mtech-ee/HighAltitudeSoilSensing/Pictures/Batteries.jpg

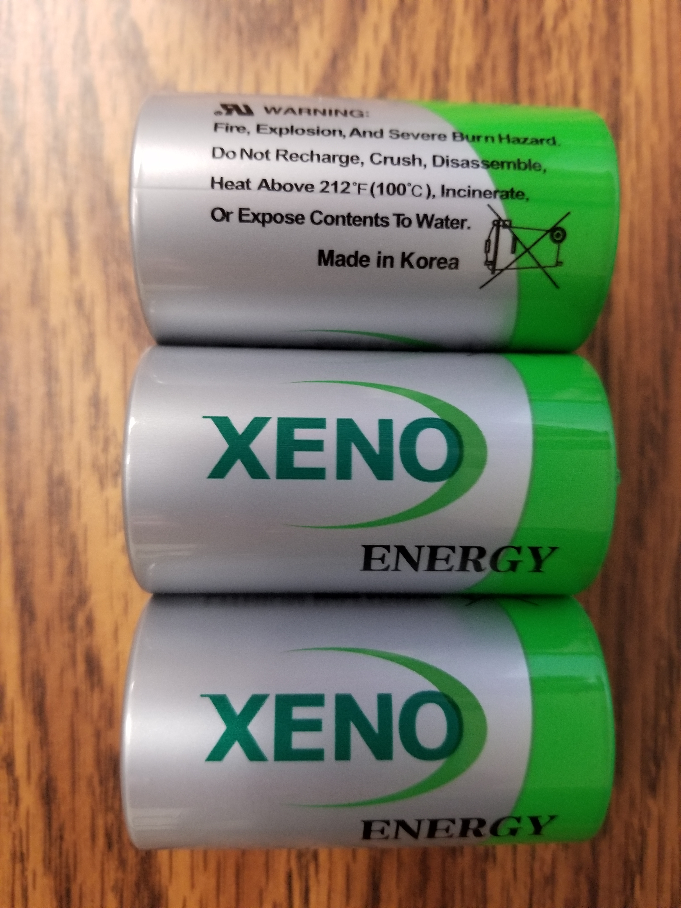
Pictures/Batteries.jpg
