mtech-ee/HighAltitudeSoilSensing/Pictures/prototype.jpg

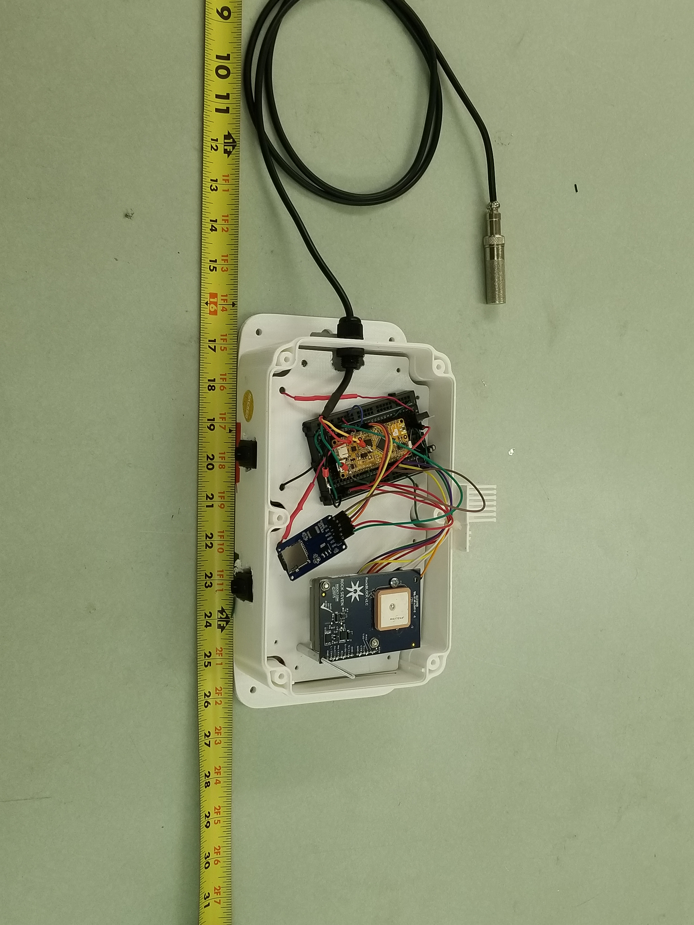
Pictures/prototype.jpg
