mtech-ee/HighAltitudeSoilSensing/README.md

# HighAltitudeSoilSensing
Reading soil temperature and moisture remotely using a RocketScream microcontroller and custom PCB
