mtech-ee/HighAltitudeSoilSensing/Documents/Senior Design/Documentation/Calculations.docx

RockBLOCK:(((2.8+4)As)/(7 days)+(8.537As)/(day))*(365 days)/(1 year)* (1 Ah)/(3600 As)=(0.9727 Ah)/(year)

Arduino:50 mA*(1 A)/(1000 mA)*(5 min)/(1 day)* (1 hour)/(60 min)* (365 days)/(1 year)=(1.521 Ah)/(year)

RocketScream:(20 mA*(1 A)/(1000 mA)*(5 min)/(1 day)* (1 hour)/(60 min)* (365 days)/(1 year))+

20 µA*(1 A)/(1*10^6 µA)*(23.917 hours)/(1 day)* (365 days)/(1 year)=(0.783 Ah)/(year)

Total:(0.9727 Ah)/(year)+(1.521 Ah)/(year)+(0.783 Ah)/(year) =(3.2767 Ah)/(year)

⁶
