mtech-ee/HighAltitudeSoilSensing/Documents/Senior Design/Documentation/Gantt Chart.xlsx

Project Planner
Select a period to highlight at right. A legend describing the charting follows. |  |  |  |  | Period Highlight: | 1 |  |  | Plan Duration |  |  |  |  |  | Actual Start |  |  |  |  | % Complete |  |  |  |  | Actual (beyond plan) |  |  |  | % Complete (beyond plan)
ACTIVITY | PLAN START | PLAN DURATION | ACTUAL START | ACTUAL DURATION | PERCENT COMPLETE | PERIODS
 |  |  |  |  |  | 1 | 2 | 3 | 4 | 5 | 6 | 7 | 8 | 9 | 10 | 11 | 12 | 13 | 14 | 15 | 16 | 17 | 18 | 19 | 20 | 21 | 22 | 23
Project Setup | 1 | 2 |  |  | 0%
Initial Attempt Work | 3 | 3 |  |  | 0%
Test Initial Prototype | 6 | 2 |  |  | 0%
Rework Initial Design | 8 | 3 |  |  | 0%
Test New Prototype | 11 | 1 |  |  | 0%
Rework Design | 12 | 2 |  |  | 0%
Test New Prototype | 14 | 1 |  |  | 0%
Rework to Final | 15 | 2 |  |  | 0%
Final Prototype | 17 | 1 |  |  | 0%
Testing & Final Tweaks | 18 | 4 |  |  | 0%
TXPO Prep | 21 | 3 |  |  | 0%
