mtech-ee/HighAltitudeSoilSensing/Documents/DataSheets/In System/RockBlock Drawing.png

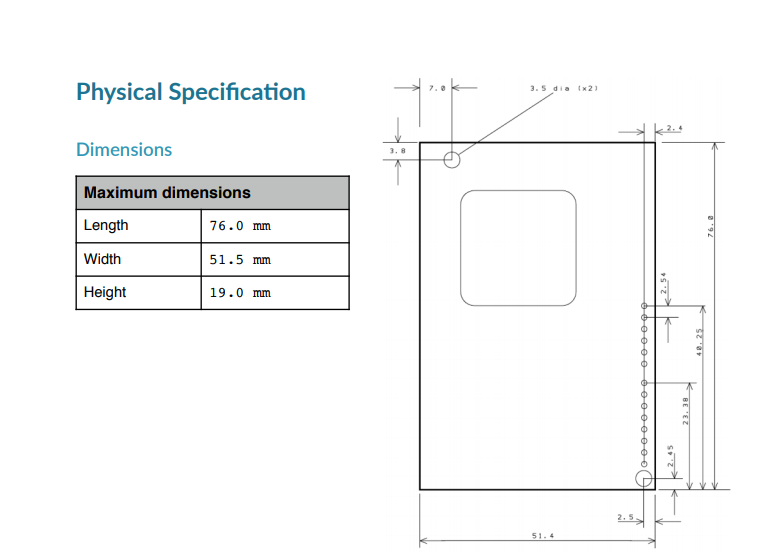
Documents/DataSheets/In System/RockBlock Drawing.png
