mtech-ee/HighAltitudeSoilSensing/Pictures/3.3V LDO.PNG

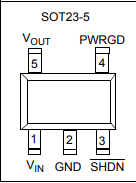
Pictures/3.3V LDO.PNG
