mtech-ee/HighAltitudeSoilSensing/Pictures/Capture.PNG

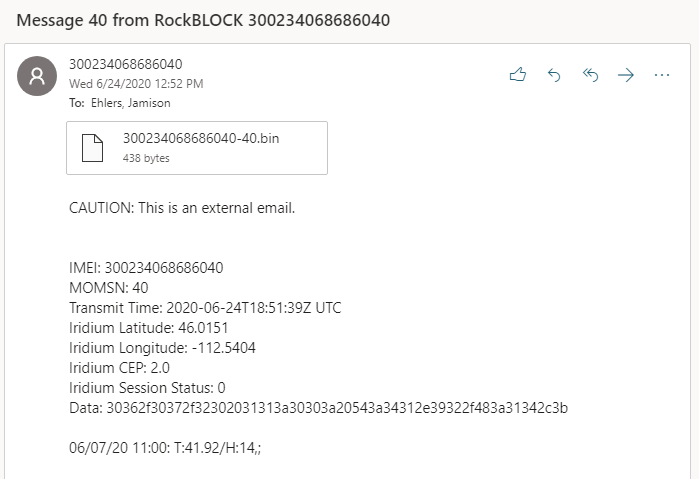
Pictures/Capture.PNG
