mtech-ee/HighAltitudeSoilSensing/Pictures/Figure1.png

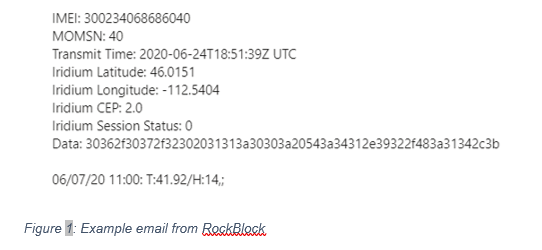
Pictures/Figure1.png
