mtech-ee/HighAltitudeSoilSensing/Pictures/HAST_PCB_v3_schematic.PNG

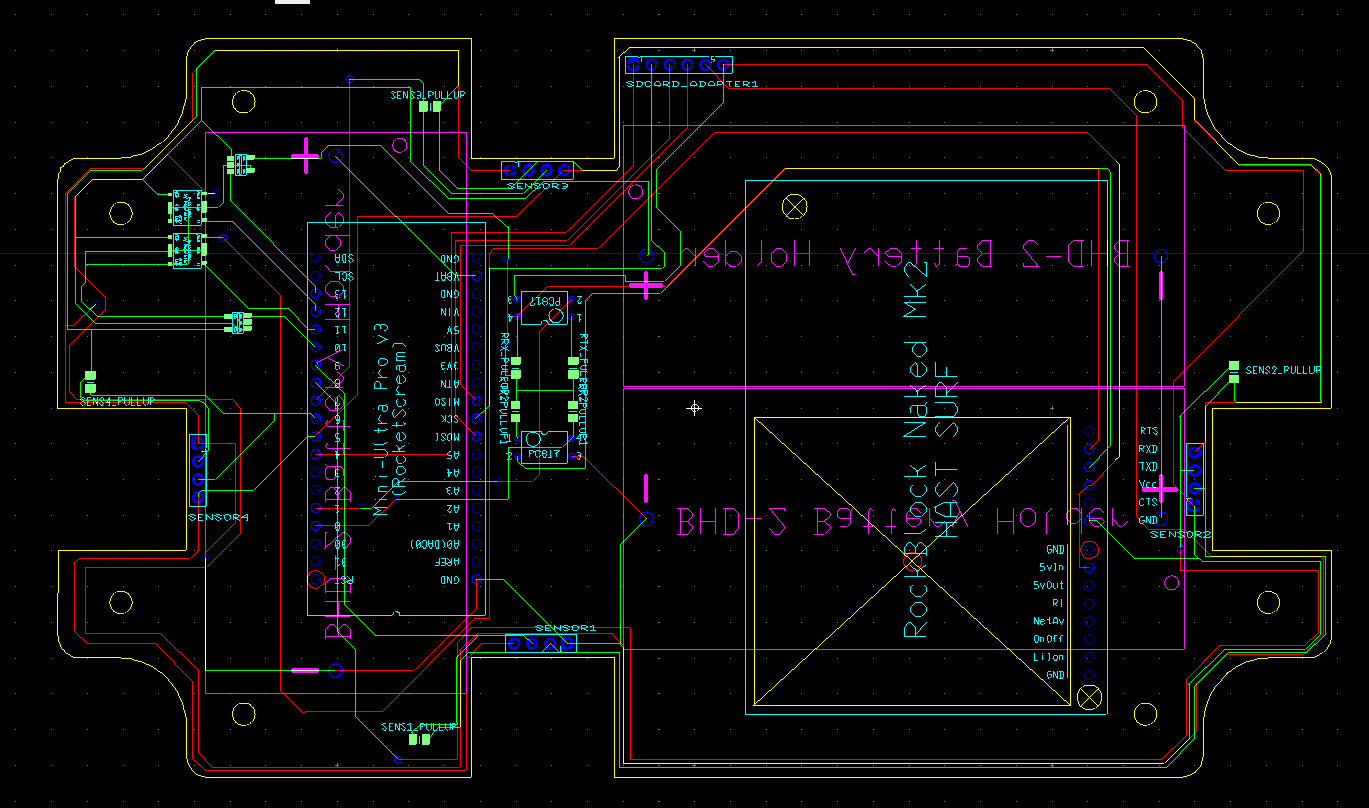
Pictures/HAST_PCB_v3_schematic.PNG
