mtech-ee/HighAltitudeSoilSensing/Pictures/Optocoupler.PNG

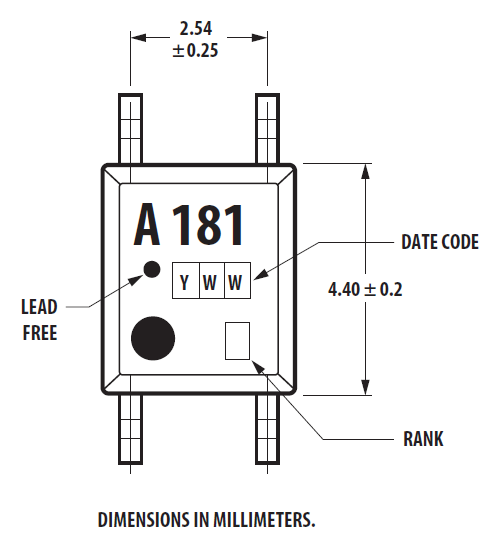
Pictures/Optocoupler.PNG
