mtech-ee/HighAltitudeSoilSensing/Pictures/prototypev2.jpg

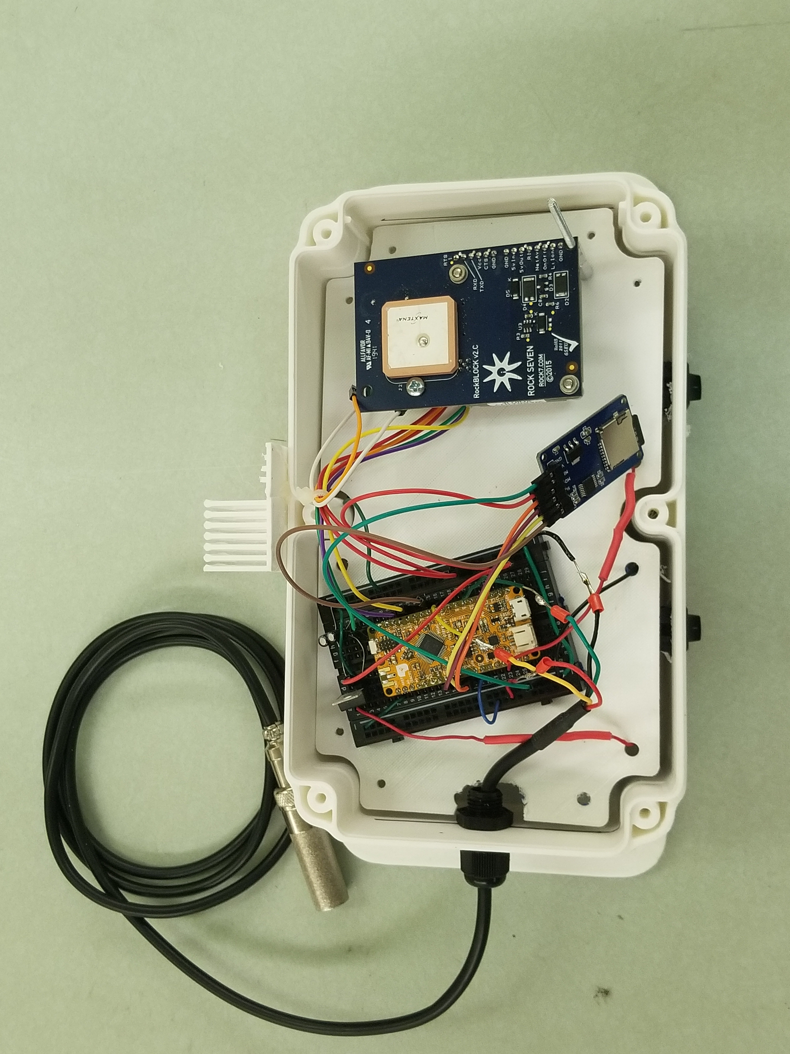
Pictures/prototypev2.jpg
