mtech-ee/HighAltitudeSoilSensing/Pictures/RockBlock.jpg

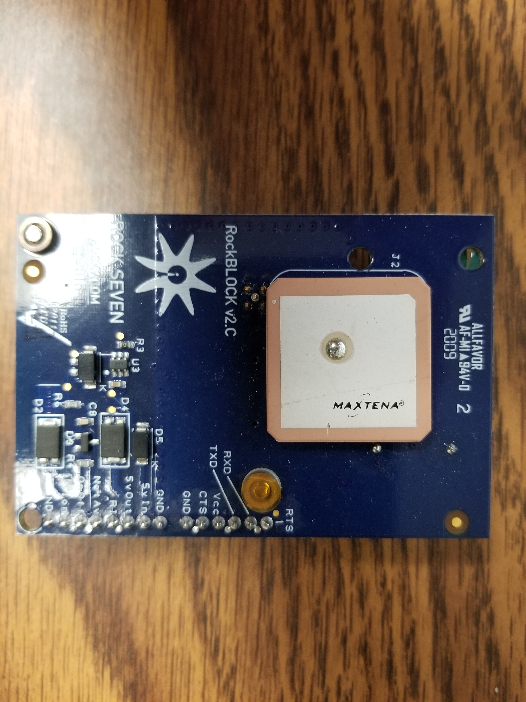
Pictures/RockBlock.jpg
