mtech-ee/HighAltitudeSoilSensing/Pictures/RocketScream.jpg

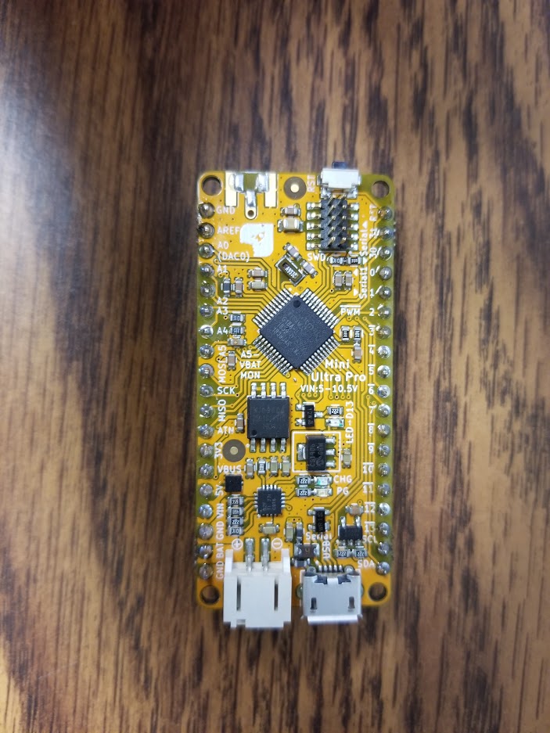
Pictures/RocketScream.jpg
