mtech-ee/HighAltitudeSoilSensing/PowerModel/CSCI477 Term Simulation Model.png

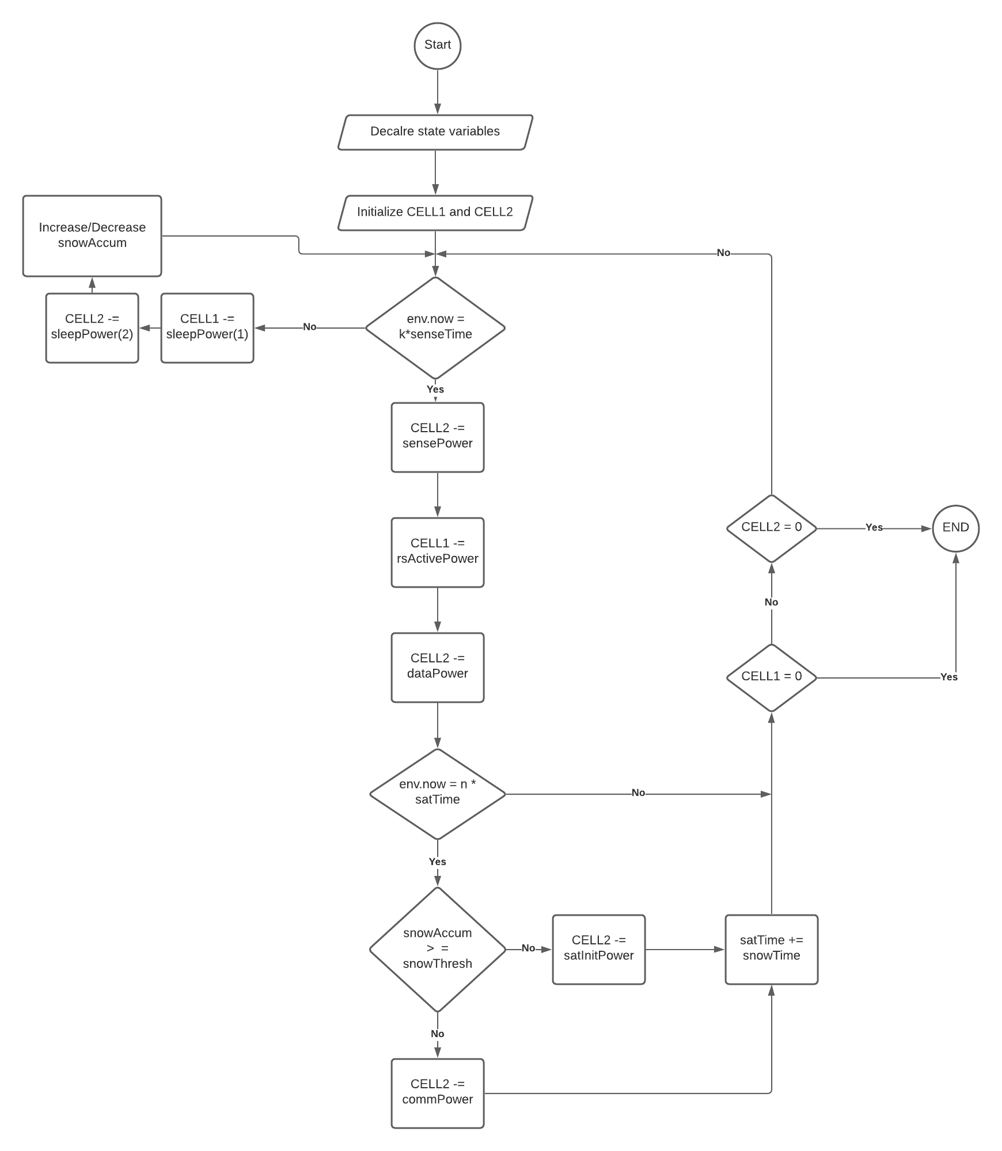
PowerModel/CSCI477 Term Simulation Model.png
