mtech-ee/HighAltitudeSoilSensing/PowerModel/TermProjectConceptualModel.png

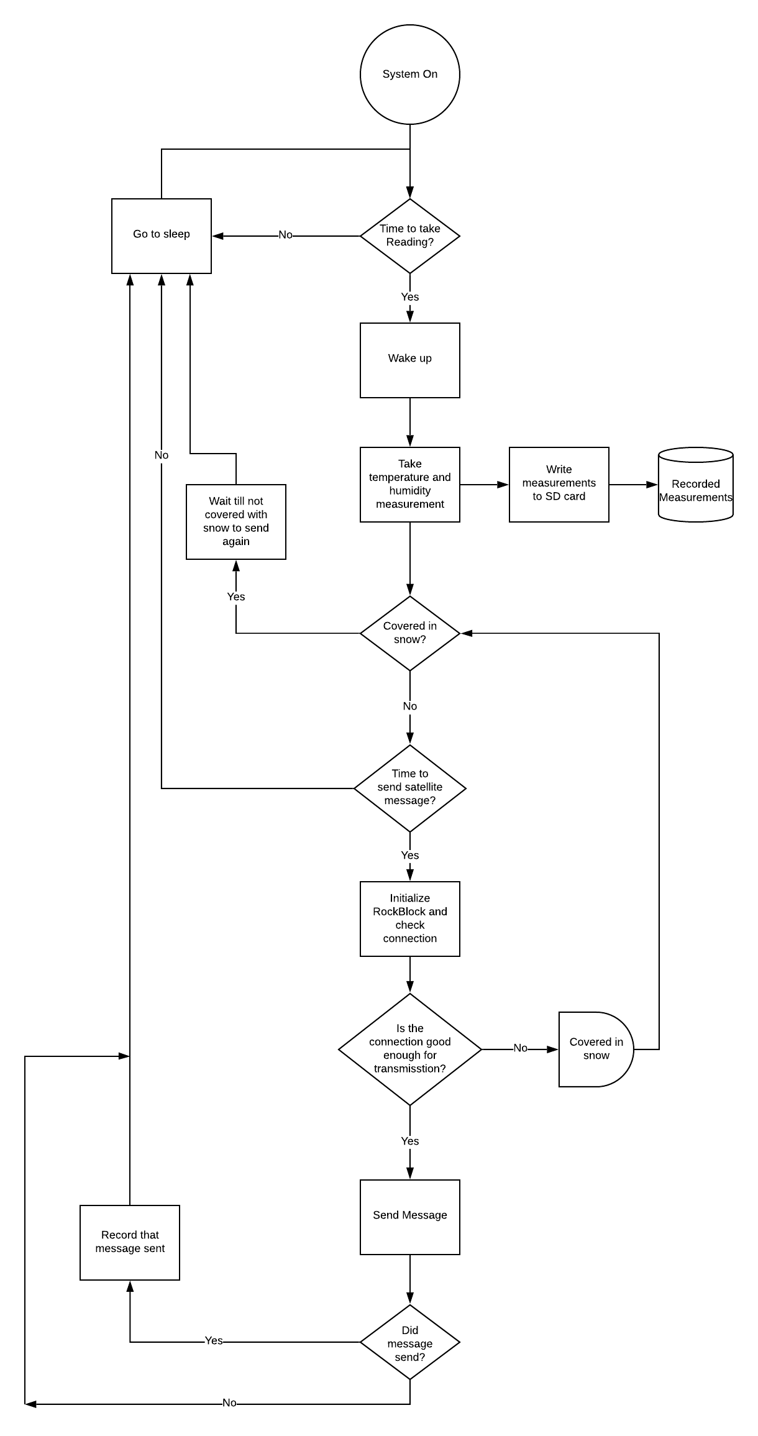
PowerModel/TermProjectConceptualModel.png
