mtech-ee/HighAltitudeSoilSensing/Documents/Inventory List.xlsx

HAST Inventory List |  | Last Updated: 10/16/2020
Component | Manufacturor # | Distributor # | Distributor | Number on Hand | Number Ordered | Units from # Components | # Per Unit | Where to Order
1 x 19 Pinheaders | PPTC191LFBN-RC | S7017-ND | Digi-Key | 25 | 0 | 9.13 | 2.74
3.3V LDO | MCP1755T-3302E/OT | 579-MCP1755T-3302EOT | Mouser | 20 | 0 | 10 | 2
3.6V Battery |  | XENO-XL-205F-OPT | Battery Junction | 3 | 0 | 1 | 3
5V LDO | R1517S502B-E2-KE | 848-R1517S502BE2KE | Mouser | 15 | 0 | 7.5 | 2
8 GB Industrial SD Card |  |  | Amazon | 2 | 0 | 2 | 1
Battery Cell Holder | BHD-2 | BHD-2-ND | Digi-Key | 12 | 0 | 4 | 3
Cable Glands |  |  | Amazon | 9 | 0 | 2.25 | 4
Capacitor (10uF) | C0805C106K8PACTU | 399-4925-2-ND | Digi-Key | 100 | 0 | 25 | 4
Mk 3 PCB |  |  | JLCPCB | 10 | 0 | 10 | 1
Resistor (150) | ERA-6AEB151V | P150DATR-ND | Digi-Key | 100 | 0 | 25 | 4
Resistor (1k) | ERA-6AEB102V | P1.0KDATR-ND | Digi-Key | 100 | 0 | 20 | 5
Resistor (3.3k) | ERA-6AEB332V | P3.3KDATR-ND | Digi-Key | 100 | 0 | 20 | 5
Resistor (330) | ERJ-PB6D3300V | P20962TR-ND | Digi-Key | 100 | 0 | 25 | 4
Rock Block Mk2 | N/A |  | Rock Block | 2 | 0 | 2 | 1
Rocket Scream | N/A |  | Rocket Scream | 1 | 0 | 1 | 1
SD Card Reader |  |  | Amazon | 11 | 0 | 11 | 1
SHT-10 |  | 1298 | Adafruit | 4 | 0 | 1 | 4
SM Optoisolator | HCPL-181-00BE | 516-1787-2-ND | Digi-Key | 19 | 0 | 9.5 | 2
Terminal Blocks | 1725672 | 651-1725672 | Mouser | 16 | 0 | 4 | 4
