mtech-ee/HighAltitudeSoilSensing/Documents/Order Lists/OrderList_12-7-2020.xlsx

Order List | 2020-12-04
Name of Component | Manufacturor | Manufacturer Part # | Distributer | Distributer # | Cost/Unit | Units | Cost | Description | TOTAL
Lithium Thionyll Batteries | Xeno | N/A | Battery Junction | N/A | $12.50 | 3 | $37.50 | 3.6 D cell batteries
SHT-10 Soil Sensors | Adafruit | 1298 | Digi-Key | 1528-2209-ND | $49.50 | 4 | $198.00 | Soil temperature/moisture sensor
Cable Glands | mxuteuk | PG7-L-BK | Amazon | PG7-L-BK | $0.48 | 20 | $9.66 | IP68 cable glands, comes in packs of 20
 |  |  |  |  |  |  |  |  | $245.16
