mtech-ee/HighAltitudeSoilSensing/Documents/Order Lists/OrderList_9-15-2020 Updated.xlsx

Order List | 2020-09-16
Name of Component | Manufacturor | Manufacturer Part # | Distributer | Distributer # | Cost/Unit | Units | Total | Description
1 X 19 Female Pin Headers (https://www.digikey.com/product-detail/en/sullins-connector-solutions/PPTC191LFBN-RC/S7017-ND/810157) | Sullins Connector Solutions | PPTC191LFBN-RC | Digi-Key | S7017-ND | 1.17 | 25 | 29.25
10uF Capactiors (https://www.digikey.com/products/en?keywords=399-4925-2-ND) | KEMET | C0805C106K8PACTU | Digi-Key | 399-4925-2-ND | 0.02585 | 100 | 2.585 | Ceramic, 0805 capacitors, rated for 10V
Screwdown terminals (https://www.mouser.com/ProductDetail/Phoenix-Contact/1725672?qs=Ul7CXFMnlWXX93F9bOV2pQ%3D%3D) | Pheonix Contact | 1725672 | Mouser | 651-1725672 | 3.31 | 20 | 66.2 | Connectors for sensors
3.3 LDO (https://www.mouser.com/ProductDetail/Microchip-Technology/MCP1755T-3302E-OT?qs=OCR3PNzn1cdSAPBsg9LlMg%3D%3D) | Microchip | MCP1755T-3302E/OT | Mouser | 579-MCP1755T-3302EOT | 0.51 | 20 | 10.2 | 3.3V Regulator
5V LDO (https://www.mouser.com/ProductDetail/Ricoh-Electronic-Devices-Company/R1517S502B-E2-KE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) | RICOH | R1517S502B-E2-KE | Mouser | 848-R1517S502BE2KE | 2.91 | 15 | 43.65 | 5V Regulator
TH Optoisolator (https://www.digikey.com/product-detail/en/taiwan-semiconductor-corporation/TPC817D-C9G/TPC817DC9G-ND/7359671) | Taiwan Semiconductor | TPC817D C9G | Digi-Key | TPC817DC9G-ND | 0.39 | 10 | 3.9 | TH Optoisolator, for testing/use for 2nd iteration of boards
SM Optoisolator (https://www.digikey.com/product-detail/en/broadcom-limited/HCPL-181-00BE/516-1787-2-ND/1234888) | Broadcom | HCPL-181-00BE | Digi-Key | 516-1787-2-ND | 0.433 | 20 | 8.66 | SM Optoisolator, for 3rd gen boards
0805 3.3k Resistors (https://www.digikey.com/product-detail/en/panasonic-electronic-components/ERA-6AEB332V/P3-3KDATR-ND/1465761) | Panasonic | ERA-6AEB332V | Digi-Key | P3.3KDATR-ND | 0.0357 | 100 | 3.57 | 3.3k Ω SM resistor
0805 330 Resistors (https://www.digikey.com/product-detail/en/panasonic-electronic-components/ERJ-PB6D3300V/P20962TR-ND/6213745) | Panasonic | ERJ-PB6D3300V | Digi-Key | P20962TR-ND | 0.0261 | 100 | 2.61 | 330 Ω SM resistor
0805 150 Resistors (https://www.digikey.com/product-detail/en/panasonic-electronic-components/ERA-6AEB151V/P150DATR-ND/1465728) | Panasonic | ERA-6AEB151V | Digi-Key | P150DATR-ND | 0.0357 | 100 | 3.57 | 150 Ω SM resistor
0805 1k Resistors (https://www.digikey.com/product-detail/en/panasonic-electronic-components/ERA-6AEB102V/P1-0KDATR-ND/1465748) | Panasonic | ERA-6AEB102V | Digi-Key | P1.0KDATR-ND | 0.0357 | 100 | 3.57 | 1k Ω SM resistor
DIP switch (https://www.digikey.com/product-detail/en/cts-electrocomponents/206-2/CT2062-ND/20733) | CTS Electrocomponents | 206-2 | Digi-Key | CT2062-ND | 0.76 | 10 | 7.6 | Power Switch
Battery Holder | Memory Protection Devices | BHD-2 | Digi-Key | BHD-2-ND | 7.52 | 12 | 90.24 | Holder for 3.6V batteries
TOTAL |  |  |  |  |  |  | 275.605
