mtech-ee/HighAltitudeSoilSensing/Documents/Bill of Materials/BillofComponents_7-21-2020.xlsx

Sheet: Total
HAST Bill Of Parts
Name of Component | Manufacturor | Manufacturer Part # | Distributer | Distributer # | Cost/Unit | Units | Total | Description
SHT-10 Sensor (https://www.adafruit.com/product/1298) | Sonbest | 31068 | Adafruit | 1298 | $49.95 | 4 | $199.80 | Soil temperature and humidity sensor
SD Card Adapter (https://www.amazon.com/HiLetgo-Adater-Interface-Conversion-Arduino/dp/B07BJ2P6X6) | HiLetGo | N/A | Amazon | B07BJ2P6X6 | $1.40 | 5 | $6.99 | SD card adapter, reads and writes to SD card, pack of 5
Industrial SD Card (https://www.amazon.com/Kingston-Digital-16GB-Industrial-SDCIT/dp/B01DOFCPNW?ref_=fsclp_pl_dp_3&th=1) | Kingston | SDCIT/8GB | Amazon | B01DOFCPNW | $11.99 | 1 | $11.99 | Low temperature rated SD card
PG7 Cable Glands (https://www.amazon.com/mxuteuk-lengthening-Connectors-Protectors-Waterproof/dp/B083NP966N?s=hi) | mxuteuk | PG7-L-BK | Amazon | B083NP966N | $0.48 | 4 | $1.93 | Cable glands for sensors, comes in packs of 20
Lithium-Thionyl Batteries | Xeno | XL-205F | Battery Junction | 658921936101 | $12.50 | 3 | $37.50 | 3.6V 19000 mAh Batteries
PC817 (https://www.digikey.com/product-detail/en/sharp-socle-technology/PC817X1NSZ0F/425-2763-ND/2451191) | SHARP/Socle Tech | PC817X1NSZ0F | Digi-Key | 425-2763-ND | $0.54 | 2 | $1.08 | Optoisolator
3.3kΩ R805 (https://www.digikey.com/product-detail/en/panasonic-electronic-components/ERA-6AEB332V/P3-3KDATR-ND/1465761) | Panasonic | ERA-6AEB332V | Digi-Key | P3.3KDATR-ND | $0.04 | 8 | $0.29 | Surface Mount 3.3kΩ Resistor
Battery Holder (https://www.digikey.com/product-detail/en/mpd-memory-protection-devices/BHD-2/BHD-2-ND/1640078) | Memory Protection Devices | BHD-2 | Digi-Key | BHD-2-ND | $7.52 | 3 | $22.56 | Holder for 3.6V batteries
1 X 19 Female Pin Headers | Sullins Connector Solutions | PPTC191LFBN-RC | Digi-Key | S7017-ND | $1.17 | 3 | $3.51
10uF Capactiors | KEMET | C0805C106K8PACTU | Digi-Key | 399-4925-2-ND | $0.03 | 5 | $0.13 | Ceramic, 0805 capacitors, rated for 10V
Custom Circuit Board (https://jlcpcb.com/) | JLCPCB | N/A | JLCPCB | N/A | $1.90 | 5 | $9.50
Screwdown terminals (https://www.mouser.com/ProductDetail/Phoenix-Contact/1725672?qs=Ul7CXFMnlWXX93F9bOV2pQ%3D%3D) | Pheonix Contact | 1725672 | Mouser | 651-1725672 | $3.31 | 4 | $13.24 | Connectors for sensors
3.3 LDO (https://www.mouser.com/ProductDetail/Microchip-Technology/MCP1755T-3302E-OT?qs=OCR3PNzn1cdSAPBsg9LlMg%3D%3D) | Microchip | MCP1755T-3302E/OT | Mouser | 579-MCP1755T-3302EOT | $0.51 | 2 | $1.02 | 3.3V Regulator
5V LDO (https://www.mouser.com/ProductDetail/Ricoh-Electronic-Devices-Company/R1517S502B-E2-KE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) | RICOH | R1517S502B-E2-KE | Mouser | 848-R1517S502BE2KE | $2.91 | 2 | $5.82 | 5V Regulator
18mm Standoff (https://www.mouser.com/ProductDetail/Harwin/R25-1001802?qs=WS5Jv%252B%252Bx1qUffmgQshpKPQ%3D%3D) | Harwin | R25-1001802 | Mouser | 855-R25-1001802 | $0.50 | 2 | $1.00
9.5 mm Standoffs (https://www.mouser.com/ProductDetail/Keystone-Electronics/4829?qs=Rc9fedAPY0Nk7yJqbzhNyg%3D%3D) | Keystone | 4829 | Mouser | 534-4829 | $0.22 | 6 | $1.32
IP68 NEMA case (https://www.polycase.com/ml-47f) | polycase | ML-47F*1508 | polycase | ML-47F*1508 | $26.46 | 1 | $26.46 | Water and dust proof NEMA case, clear lid
RockBlock (https://www.rock7.com/shop-product-detail?productId=46) | Rock Seven | N/A | RockBlock | N/A | $249.00 | 1 | $249.00 | Satellite modem, PATCH ANTENNA OPTION, message credits and line fee not included
Mini Ultra Pro V3 w/out Radio (https://www.rocketscream.com/blog/product/mini-ultra-pro-v3-without-radio/) | RocketScream | N/A | RocketScream | N/A | $24.90 | 1 | $24.90 | Low power microcontroller
 |  |  |  |  |  | TOTAL | $618.04

Sheet: To-Order for Symposium
HAST Bill Of Parts
Name of Component | Manufacturor | Manufacturer Part # | Distributer | Distributer # | Cost/Unit | Units | Total | Description
PC817 (https://www.digikey.com/product-detail/en/sharp-socle-technology/PC817X1NSZ0F/425-2763-ND/2451191) | SHARP/Socle Tech | PC817X1NSZ0F | Digi-Key | 425-2763-ND | $0.54 | 2 | $1.08 | Optoisolator
3.3kΩ R805 (https://www.digikey.com/product-detail/en/panasonic-electronic-components/ERA-6AEB332V/P3-3KDATR-ND/1465761) | Panasonic | ERA-6AEB332V | Digi-Key | P3.3KDATR-ND | $0.04 | 8 | $0.29 | Surface Mount 3.3kΩ Resistor, 0.125W, 0805 Package
1 X 19 Female Pin Headers (https://www.digikey.com/product-detail/en/sullins-connector-solutions/PPTC191LFBN-RC/S7017-ND/810157) | Sullins Connector Solutions | PPTC191LFBN-RC | Digi-Key | S7017-ND | $1.17 | 3 | $3.51
10uF Capactiors | KEMET | C0805C106K8PACTU | Digi-Key | 399-4925-2-ND | $0.03 | 5 | $0.13 | Ceramic, 0805 capacitors, rated for 10V
Custom Circuit Board (https://jlcpcb.com/) | JLCPCB | N/A | JLCPCB | N/A | $1.90 | 5 | $9.50 | Jamison can order, just let know
Screwdown terminals (https://www.mouser.com/ProductDetail/Phoenix-Contact/1725672?qs=Ul7CXFMnlWXX93F9bOV2pQ%3D%3D) | Pheonix Contact | 1725672 | Mouser | 651-1725672 | $3.31 | 4 | $13.24 | Connectors for sensors
3.3 LDO (https://www.mouser.com/ProductDetail/Microchip-Technology/MCP1755T-3302E-OT?qs=OCR3PNzn1cdSAPBsg9LlMg%3D%3D) | Microchip | MCP1755T-3302E/OT | Mouser | 579-MCP1755T-3302EOT | $0.51 | 2 | $1.02 | 3.3V Regulator
5V LDO (https://www.mouser.com/ProductDetail/Ricoh-Electronic-Devices-Company/R1517S502B-E2-KE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) | RICOH | R1517S502B-E2-KE | Mouser | 848-R1517S502BE2KE | $2.91 | 2 | $5.82 | 5V Regulator
18mm Standoff (https://www.mouser.com/ProductDetail/Harwin/R25-1001802?qs=WS5Jv%252B%252Bx1qUffmgQshpKPQ%3D%3D) | Harwin | R25-1001802 | Mouser | 855-R25-1001802 | $0.50 | 2 | $1.00
9.5 mm Standoffs (https://www.mouser.com/ProductDetail/Keystone-Electronics/4829?qs=Rc9fedAPY0Nk7yJqbzhNyg%3D%3D) | Keystone | 4829 | Mouser | 534-4829 | $0.22 | 6 | $1.32
IP68 NEMA case (https://www.polycase.com/ml-47f) | polycase | ML-47F*1508 | polycase | ML-47F*1508 | $26.46 | 1 | $26.46 | Water and dust proof NEMA case, clear lid. ML-47F
 |  |  |  |  |  | TOTAL | $63.36

Sheet: Case Materials
HAST Bill Of Parts
Name of Component | Manufacturor | Manufacturer Part # | Distributer | Distributer # | Cost/Unit | Units | Total | Description
PG7 Cable Glands (https://www.amazon.com/mxuteuk-lengthening-Connectors-Protectors-Waterproof/dp/B083NP966N?s=hi) | mxuteuk | PG7-L-BK | Amazon | B083NP966N | $0.48 | 4 | $1.93 | Cable glands for sensors, comes in packs of 20
IP68 NEMA case (https://www.polycase.com/ml-47f) | polycase | ML-47F*1508 | polycase | ML-47F*1508 | $26.46 | 1 | $26.46 | Water and dust proof NEMA case, clear lid
 |  |  |  |  |  | TOTAL | $28.39

Sheet: Electronics
HAST Bill Of Parts
Name of Component | Manufacturor | Manufacturer Part # | Distributer | Distributer # | Cost/Unit | Units | Total | Description
SHT-10 Sensor (https://www.adafruit.com/product/1298) | Sonbest | 31068 | Adafruit | 1298 | $49.95 | 4 | $199.80 | Soil temperature and humidity sensor
SD Card Adapter (https://www.amazon.com/HiLetgo-Adater-Interface-Conversion-Arduino/dp/B07BJ2P6X6) | HiLetGo | N/A | Amazon | B07BJ2P6X6 | $1.40 | 5 | $6.99 | SD card adapter, reads and writes to SD card, pack of 5
Industrial SD Card (https://www.amazon.com/Kingston-Digital-16GB-Industrial-SDCIT/dp/B01DOFCPNW?ref_=fsclp_pl_dp_3&th=1) | Kingston | SDCIT/8GB | Amazon | B01DOFCPNW | $11.99 | 1 | $11.99 | Low temperature rated SD card
RockBlock (https://www.rock7.com/shop-product-detail?productId=46) | Rock Seven | N/A | RockBlock | N/A | $249.00 | 1 | $249.00 | Satellite modem, PATCH ANTENNA OPTION, message credits and line fee not included
Mini Ultra Pro V3 w/out Radio (https://www.rocketscream.com/blog/product/mini-ultra-pro-v3-without-radio/) | RocketScream | N/A | RocketScream | N/A | $24.90 | 1 | $24.90 | Low power microcontroller
 |  |  |  |  |  | TOTAL | $492.68

Sheet: Components
HAST Bill Of Parts
Name of Component | Manufacturor | Manufacturer Part # | Distributer | Distributer # | Cost/Unit | Units | Total | Description
Lithium-Thionyl Batteries | Xeno | XL-205F | Battery Junction | 658921936101 | $12.50 | 3 | $37.50 | 3.6V 19000 mAh Batteries
PC817 (https://www.digikey.com/product-detail/en/sharp-socle-technology/PC817X1NSZ0F/425-2763-ND/2451191) | SHARP/Socle Tech | PC817X1NSZ0F | Digi-Key | 425-2763-ND | $0.54 | 2 | $1.08 | Optoisolator
3.3kΩ R805 (https://www.digikey.com/product-detail/en/panasonic-electronic-components/ERA-6AEB332V/P3-3KDATR-ND/1465761) | Panasonic | ERA-6AEB332V | Digi-Key | P3.3KDATR-ND | $0.04 | 8 | $0.29 | Surface Mount 3.3kΩ Resistor
Battery Holder (https://www.digikey.com/product-detail/en/mpd-memory-protection-devices/BHD-2/BHD-2-ND/1640078) | Memory Protection Devices | BHD-2 | Digi-Key | BHD-2-ND | $7.52 | 3 | $22.56 | Holder for 3.6V batteries
1 X 19 Female Pin Headers | Sullins Connector Solutions | PPTC191LFBN-RC | Digi-Key | S7017-ND | $1.17 | 3 | $3.51
Custom Circuit Board (https://jlcpcb.com/) | JLCPCB | N/A | JLCPCB | N/A | $1.90 | 5 | $9.50
Screwdown terminals (https://www.mouser.com/ProductDetail/Phoenix-Contact/1725672?qs=Ul7CXFMnlWXX93F9bOV2pQ%3D%3D) | Pheonix Contact | 1725672 | Mouser | 651-1725672 | $3.31 | 4 | $13.24 | Connectors for sensors
3.3 LDO (https://www.mouser.com/ProductDetail/Microchip-Technology/MCP1755T-3302E-OT?qs=OCR3PNzn1cdSAPBsg9LlMg%3D%3D) | Microchip | MCP1755T-3302E/OT | Mouser | 579-MCP1755T-3302EOT | $0.51 | 2 | $1.02 | 3.3V Regulator
5V LDO (https://www.mouser.com/ProductDetail/Ricoh-Electronic-Devices-Company/R1517S502B-E2-KE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) | RICOH | R1517S502B-E2-KE | Mouser | 848-R1517S502BE2KE | $2.91 | 2 | $5.82 | 5V Regulator
18mm Standoff (https://www.mouser.com/ProductDetail/Harwin/R25-1001802?qs=WS5Jv%252B%252Bx1qUffmgQshpKPQ%3D%3D) | Harwin | R25-1001802 | Mouser | 855-R25-1001802 | $0.50 | 2 | $1.00
9.5 mm Standoffs (https://www.mouser.com/ProductDetail/Keystone-Electronics/4829?qs=Rc9fedAPY0Nk7yJqbzhNyg%3D%3D) | Keystone | 4829 | Mouser | 534-4829 | $0.22 | 6 | $1.32
10uF Capactiors | KEMET | C0805C106K8PACTU | Digi-Key | 399-4925-2-ND | $0.03 | 5 | $0.13 | Ceramic, 0805 capacitors, rated for 10V
 |  |  |  |  |  | TOTAL | $96.96
