mtech-ee/HighAltitudeSoilSensing/Fabrication/Case/Other/drill_jig_Mk2.SLDPRT

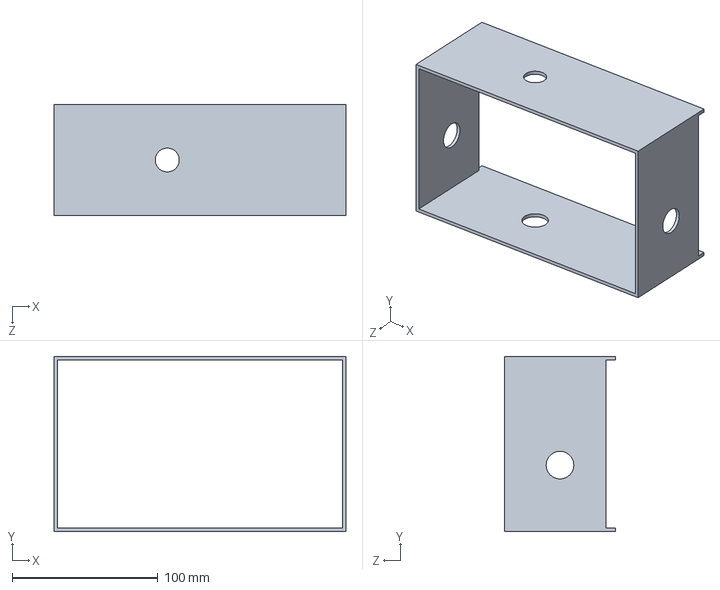
[picture p50: CAD file, 2020-12-08]
Fabrication/Case/Other/drill_jig_Mk2.SLDPRT
200.7 x 120.5 x 76.2 mm
