mtech-ee/HighAltitudeSoilSensing/Fabrication/PCB/Drawings/SDCard_Outline.dxf

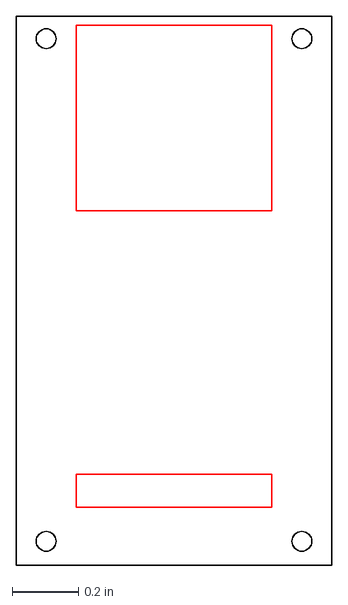
[picture p51: CAD file, 2020-12-08]
Fabrication/PCB/Drawings/SDCard_Outline.dxf
0.952 x 1.65 in
