mtech-ee/HighAltitudeSoilSensing/Fabrication/PCB/SolidWorks/Drillout_EastWest_Wall.SLDPRT

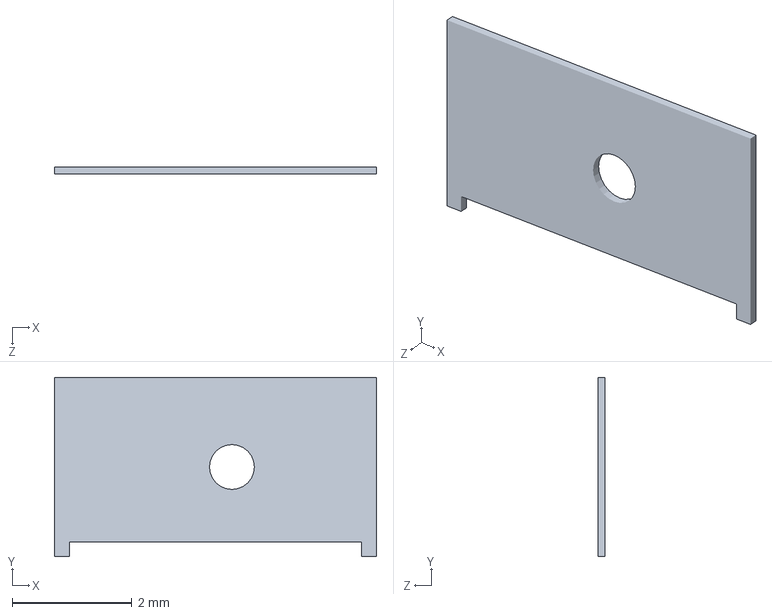
[picture p52: CAD file, 2020-12-08]
Fabrication/PCB/SolidWorks/Drillout_EastWest_Wall.SLDPRT
5.38 x 3.00 x 0.125 mm
