mtech-ee/HighAltitudeSoilSensing/Schematics/PCB/Versions/Version 3/Ultiboard Exports/HAST_PCB_v3 - 3D.dxf

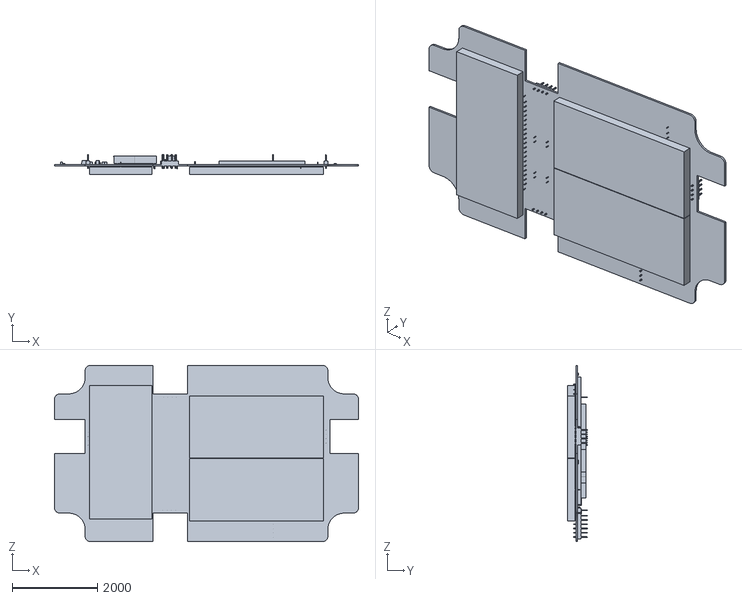
[picture p53: CAD file, 2020-12-08]
Schematics/PCB/Versions/Version 3/Ultiboard Exports/HAST_PCB_v3 - 3D.dxf
7128.5 x 476.8 x 4133.5
