mtech-ee/HighAltitudeSoilSensing/Fabrication/Case/Other/Part1.SLDPRT

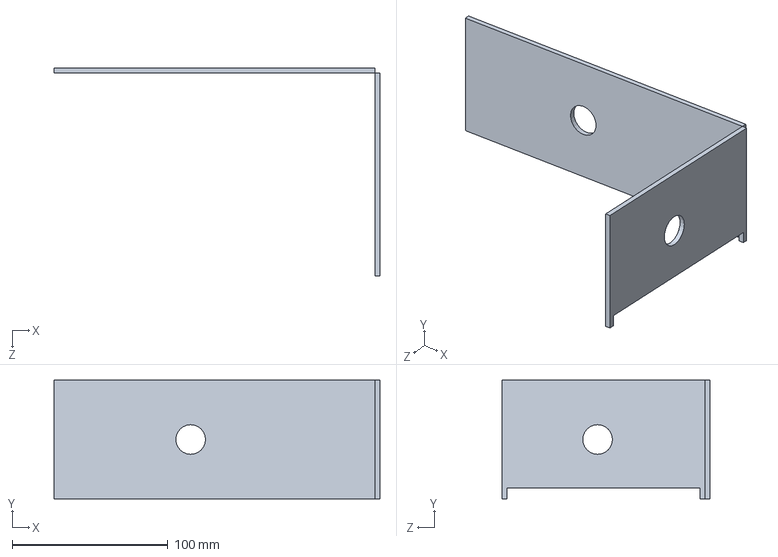
[picture p54: CAD file, 2020-12-08]
Fabrication/Case/Other/Part1.SLDPRT
209.6 x 76.2 x 133.6 mm
