mtech-ee/HighAltitudeSoilSensing/Fabrication/PCB/Drawings/NEMA_Case_Drillout_SouthWall.stl

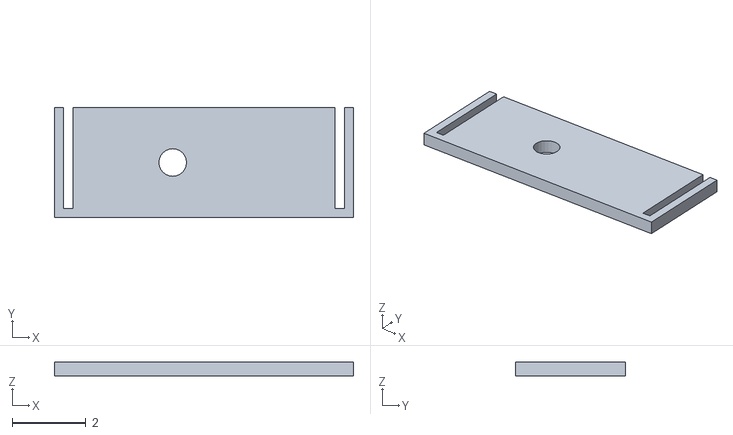
[picture p55: CAD file, 2020-12-08]
Fabrication/PCB/Drawings/NEMA_Case_Drillout_SouthWall.stl
8.13 x 3.00 x 0.377
