mtech-ee/HighAltitudeSoilSensing/Fabrication/PCB/SolidWorks/NEMA_Case_Drillout_SouthWall_v2.SLDPRT

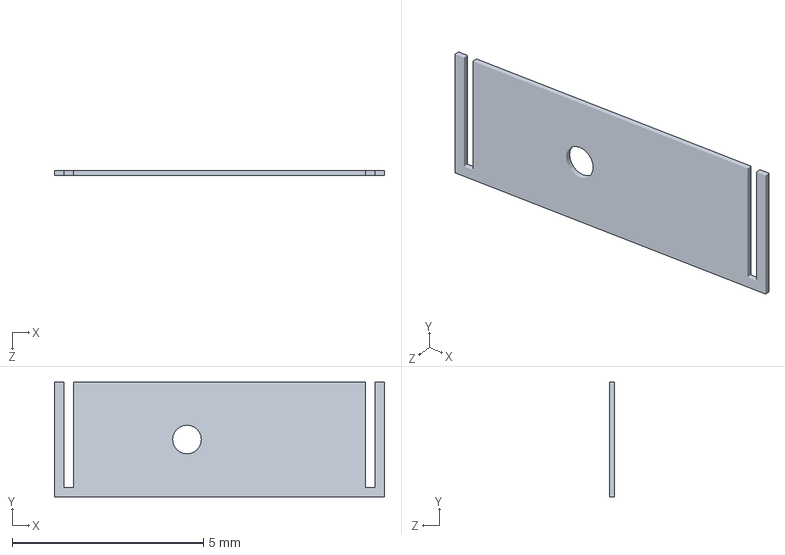
[picture p56: CAD file, 2020-12-08]
Fabrication/PCB/SolidWorks/NEMA_Case_Drillout_SouthWall_v2.SLDPRT
8.63 x 3.00 x 0.125 mm
