mtech-ee/HighAltitudeSoilSensing/Schematics/PCB/Versions/Version 3/Ultiboard Exports/HAST_PCB_v3.dxf

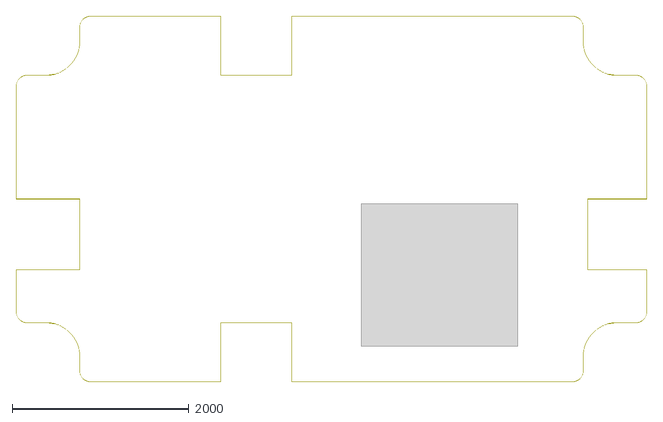
[picture p57: CAD file, 2020-12-08]
Schematics/PCB/Versions/Version 3/Ultiboard Exports/HAST_PCB_v3.dxf
7128.5 x 4133.5
