mtech-ee/HighAltitudeSoilSensing/Fabrication/PCB/Drawings/PCB.STL

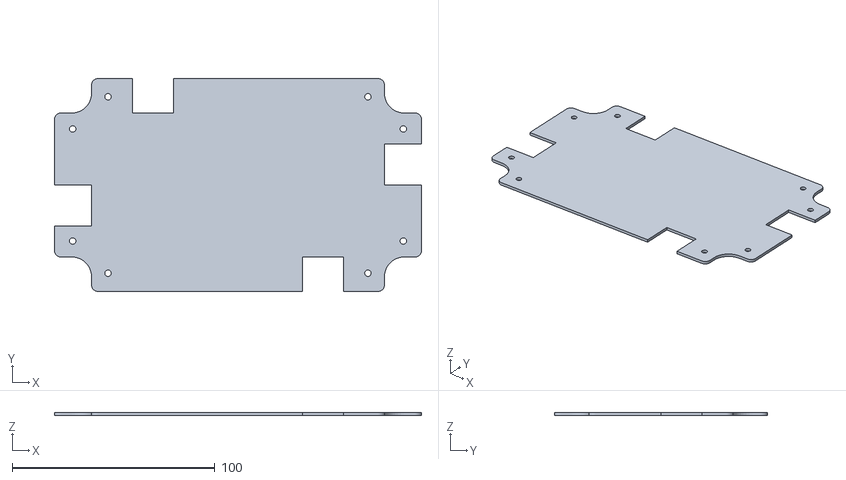
[picture p58: CAD file, 2020-12-08]
Fabrication/PCB/Drawings/PCB.STL
181.1 x 105.0 x 1.57
