mtech-ee/HighAltitudeSoilSensing/Fabrication/PCB/Drawings/PCB_outline_v2.dxf

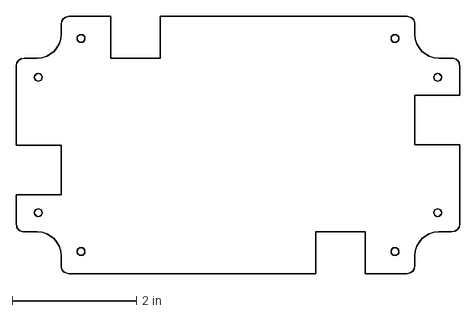
[picture p59: CAD file, 2020-12-08]
Fabrication/PCB/Drawings/PCB_outline_v2.dxf
7.13 x 4.13 in
