mtech-ee/HighAltitudeSoilSensing/Fabrication/PCB/Drawings/HAST_PCB_v3.dxf

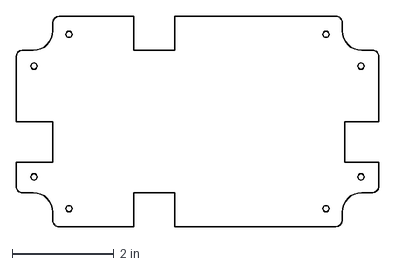
[picture p60: CAD file, 2020-12-08]
Fabrication/PCB/Drawings/HAST_PCB_v3.dxf
7.13 x 4.13 in
