mtech-ee/HighAltitudeSoilSensing/Fabrication/PCB/Drawings/NEMA_Case_Drillout_East_Wall.stl

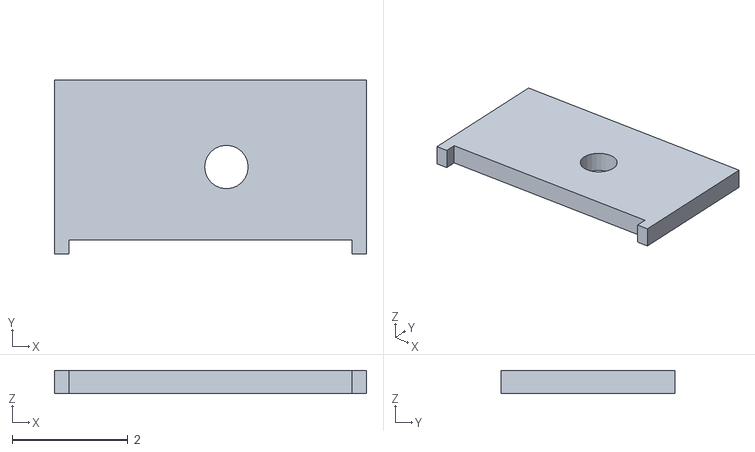
[picture p61: CAD file, 2020-12-08]
Fabrication/PCB/Drawings/NEMA_Case_Drillout_East_Wall.stl
5.38 x 3.00 x 0.4
