mtech-ee/HighAltitudeSoilSensing/Fabrication/PCB/Drawings/Drillout_NorthSouth_Wall.stl

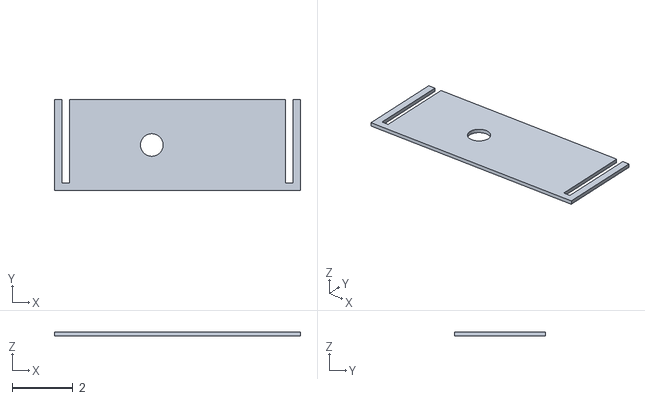
[picture p62: CAD file, 2020-12-08]
Fabrication/PCB/Drawings/Drillout_NorthSouth_Wall.stl
8.13 x 3.00 x 0.125
