mtech-ee/HighAltitudeSoilSensing/Fabrication/Gerber/8-6-2020/HAST_PCB_v3.dxf

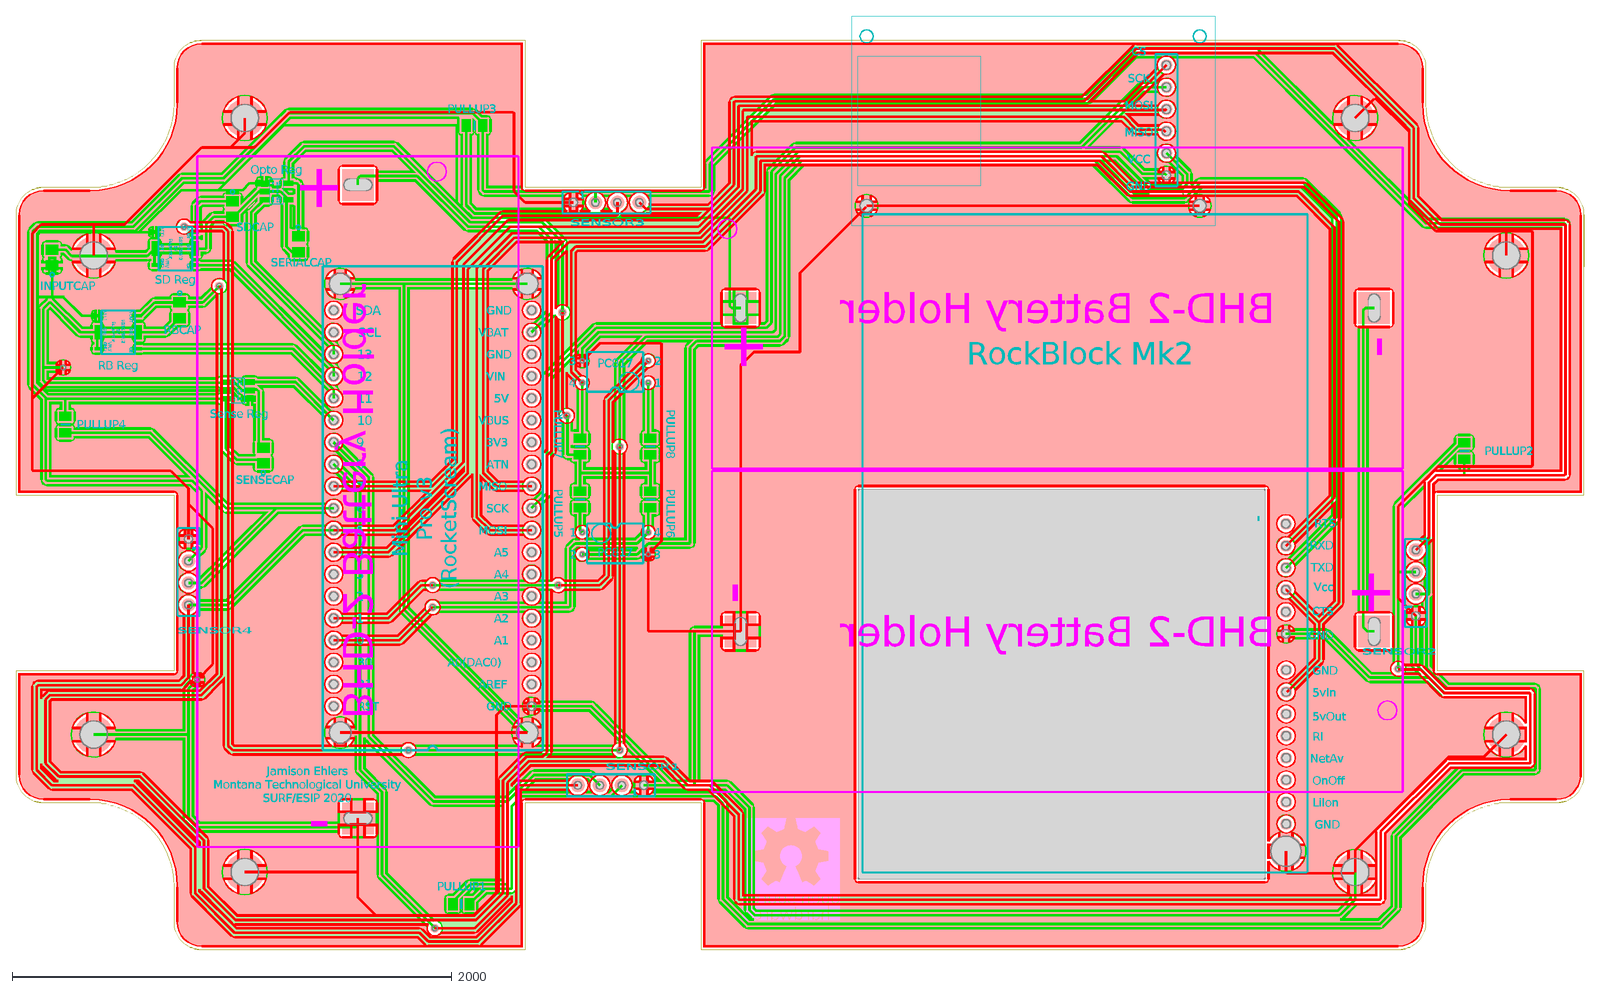
[picture p63: CAD file, 2020-12-08, an earlier design]
Fabrication/Gerber/8-6-2020/HAST_PCB_v3.dxf
Jamison Ehlers Montana Technological University SURF/ESIP 2020
1
2
4
3
PC817
SENSOR3
PULLUP1
PULLUP3
RockBlock Mk2
GND
LiIon
OnOff
NetAv
RI
5vOut
5vIn
CTS
Vcc
RXD
TXD
RTS
SD Reg
RB Reg
Sense Reg
Opto Reg
Mini-Ultra Pro v3 (RocketScream)
AREF
A0(DAC0)
A1
A2
A3
A4
A5
MOSI
SCK
MISO
ATN
3V3
VBUS
5V
VIN
VBAT
RST
31
30
0
5
6
7
8
9
10
11
12
13
SCL
SDA
SERIALCAP
SDCAP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
