mtech-ee/HighAltitudeSoilSensing/(list of files, cad)

Other CAD files:
Fabrication/PCB/Drawings/DrillKit_HAST.dwg
Fabrication/PCB/Drawings/NEMA_Case_Drillout_East_Wall2.stl
Fabrication/PCB/Drawings/Drillout_EastWest_Wall.stl
Fabrication/PCB/Drawings/NEMA_Case_Drillout_SouthWall_v2.stl
Fabrication/PCB/Drawings/HAST_PCB_v3.dwg
Fabrication/PCB/Drawings/NEMA_Case_Drillout_East_Wall.dwg
Fabrication/PCB/Drawings/NEMA_Case_Drillout_SouthWall.dwg
Fabrication/PCB/Drawings/PCB_outline_v2.dwg
Fabrication/PCB/Drawings/SDCard_Outline.dwg
Schematics/PCB/Old/To Order/Ultiboard Exports/HAST_PCB_v3.dxf
Schematics/PCB/Old/ToPrint/HAST_PCB_v3.dwg
Schematics/PCB/Old/ToPrint/HAST_PCB_v3.dxf
Schematics/PCB/Old/Ultiboard Exports/HAST_PCB_1 - 3D.dwg
Schematics/PCB/Old/Ultiboard Exports/HAST_PCB_1 - 3D.dxf
Schematics/PCB/Old/Ultiboard Exports/HAST_PCB_1.dxf
