mtech-ee/HighAltitudeSoilSensing/PowerModel/experiment.txt

/**
 * CSCI4-577 Computational Modeling and Simulation
 *
 * Term Simulation Project - Experiment Description
 */

 Name: 
 
 Date: 
 
 Description:
