mtech-ee/HighAltitudeSoilSensing/Documents/Bug Tracking.xlsx

Bug Tracking High Altitude Soil Testing |  |  |  | Last Updated: | 2020-12-08
Issue Type | Subject | Status | Start Date
Software | Re-implement module code | Finished | 2020-08-26
Hardware | Implement Switch for Overall Power | Finished | 2020-08-26
Hardware | Change footprint on optocoupler from TH to SMD | Finished | 2020-08-26
Hardware | Order new sensor terminal blocks | Finished | 2020-08-26
Hardware | Reroute traces around battery terminals | Finished | 2020-08-26
Hardware | Fix routing along bottom edge | Finished | 2020-08-26
Hardware | Fix 5V regulator for SD card reader | Finished | 2020-08-26
Hardware | Label pins for sensor terminals | Finished | 2020-08-26
Hardware | Add pullup to clock line | Finished | 2020-08-27
Software | Add data encoding to code | In Progress | 2020-09-01
Hardware | Swap Serial lines on PCB | Finished | 2020-09-10
Hardware | Add current test spots on PCB | Finished | 2020-09-21
Hardware | Mitiagate sensor quiescent current | Not Started
