mtech-ee/HighAltitudeSoilSensing/(list of files, drawings)

Other design files:
Schematics/Multisim/New Design/HAST_PCB.ms14
Schematics/Multisim/New Design/PCB_CircuitDiagram_v3/HAST_PCB_v3.ms14
Schematics/Multisim/Old Design/HAST Arduino Shield v1.1.ms14
Schematics/Multisim/Old Design/HAST Arduino Shield v1.ms14
Schematics/Multisim/Old Design/HAST Arduino Shield v2.ms14
