mtech-ee/HighAltitudeSoilSensing/(commit log)

2020-12-08 Add files via upload
    Added Fabrication
    [DrillKit_HAST.dwg, Drillout_EastWest_Wall.SLDPRT, Drillout_EastWest_Wall.stl, Drillout_NorthSouth_Wall.stl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]
2020-12-08 Added Old Design
    [HAST Arduino Shield v1.1.ms14, HAST Arduino Shield v1.ms14, HAST Arduino Shield v2.ms14]
2020-12-08 added PCB
    [HAST_PCB_1 - 3D.dwg, HAST_PCB_1 - 3D.dxf, HAST_PCB_1.dxf, HAST_PCB_v3 - 3D.dxf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]
2020-12-08 Added Bug Tracking and Inventory List
    [Bug Tracking.xlsx, Inventory List.xlsx]
2020-12-08 Added Bill of Materials
    [BillOfMaterials_7-20-2020.xlsx, BillofComponents_7-21-2020.xlsx, BillofMaterials_7-21-2020.xlsx, CostSheet.xlsx]
2020-12-08 Added Order Lists
    [OrderList_12-7-2020.xlsx, OrderList_9-15-2020 Updated.xlsx]
2020-12-08 Added Senior Design
    [Gantt Chart.xlsx]
2020-12-08 Added ArduinoToTest_v2
