mtech-ee/HighAltitudeSoilSensing/Pictures/SDCardAdapter.jpg

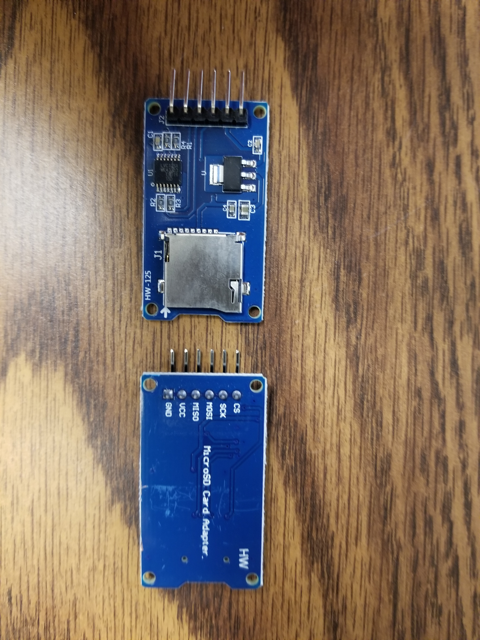
Pictures/SDCardAdapter.jpg
